rallepalaveev/A2Pico2Lite/TH/A2PicoLite-bare.png

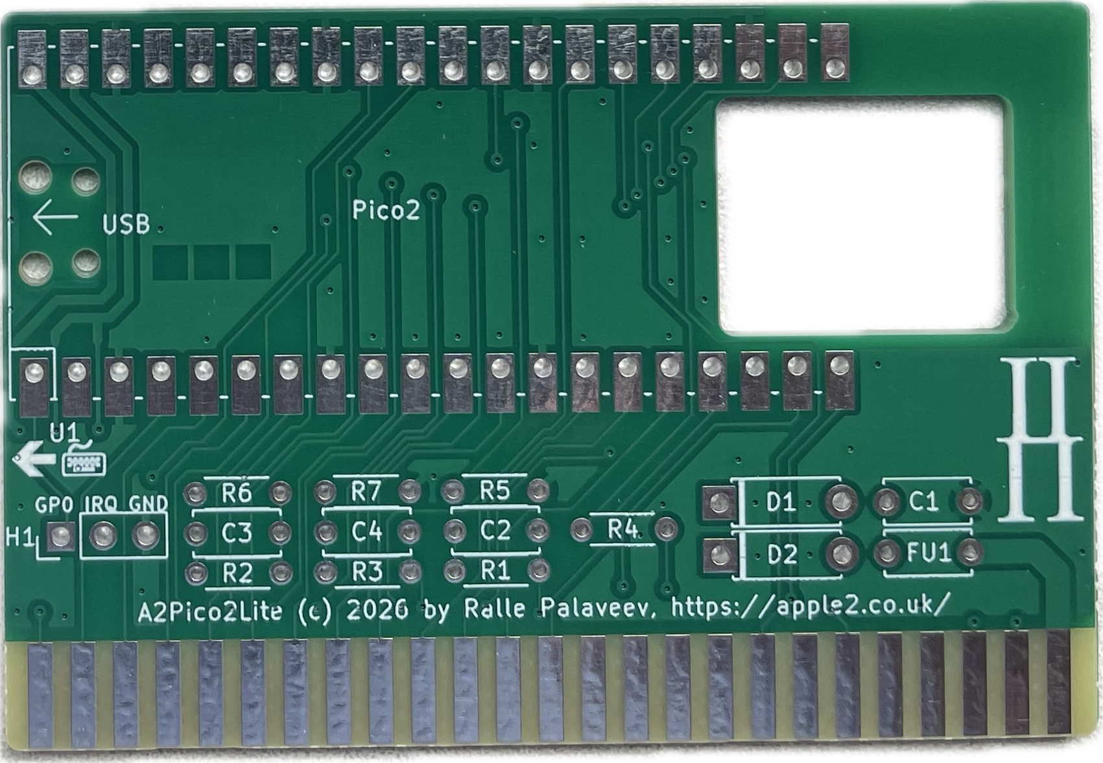
TH/A2PicoLite-bare.png
