rallepalaveev/A2Pico2Lite/TH/A2Pico2Lite.jpg

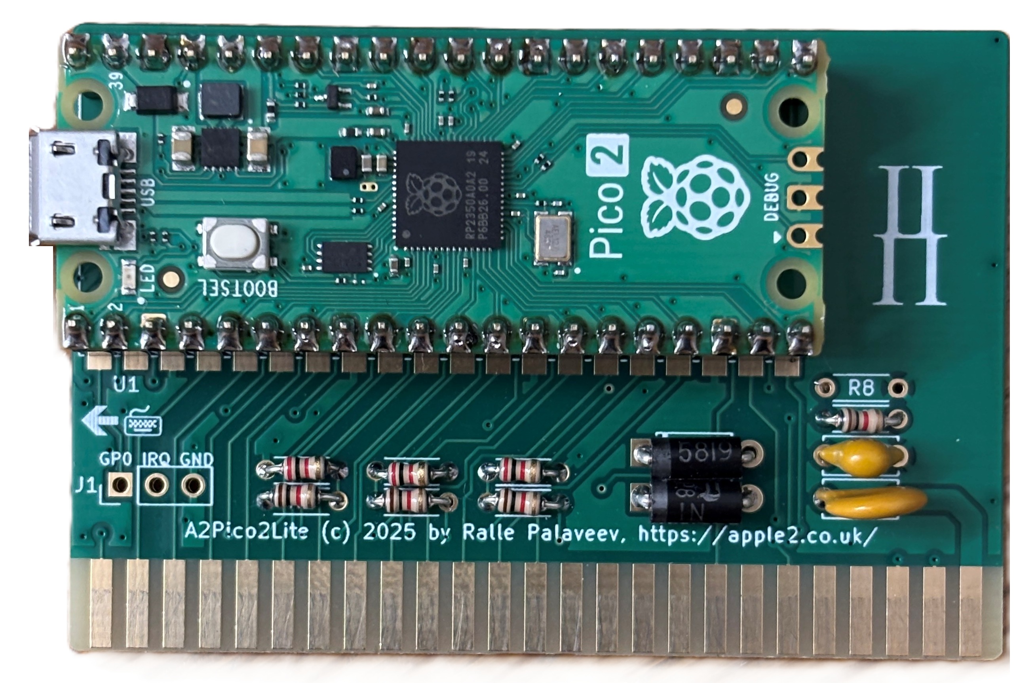
TH/A2Pico2Lite.jpg
