rallepalaveev/A2Pico2Lite/SMT/A2Pico2LiteSMD.jpg

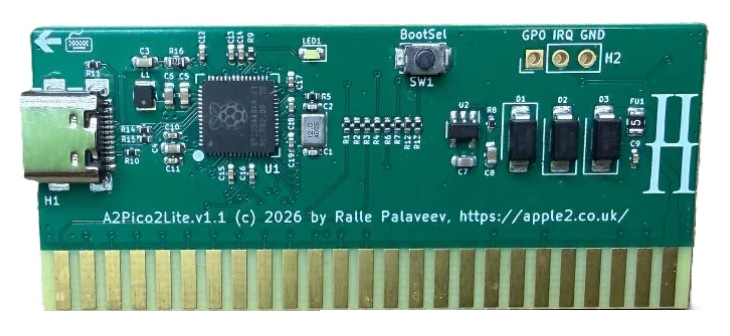
SMT/A2Pico2LiteSMD.jpg
