rallepalaveev/A2Pico2Lite/TH/A2Pico2Lite.png

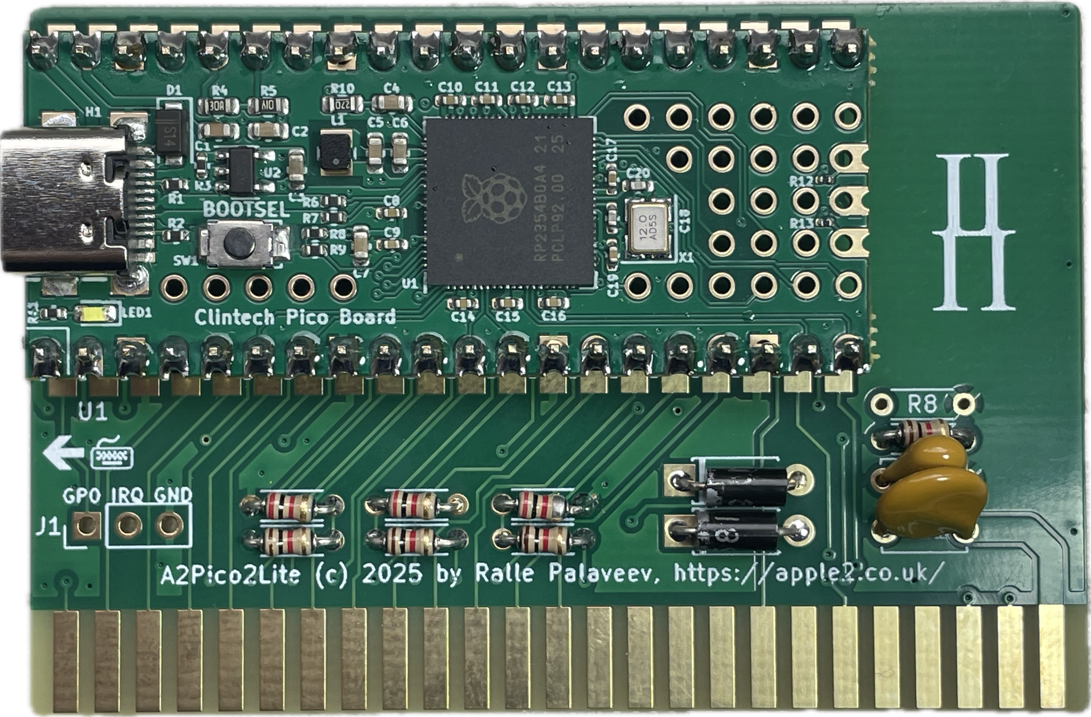
TH/A2Pico2Lite.png
