rallepalaveev/A2Pico2Lite/TH/A2Pico2Lite_render.jpg

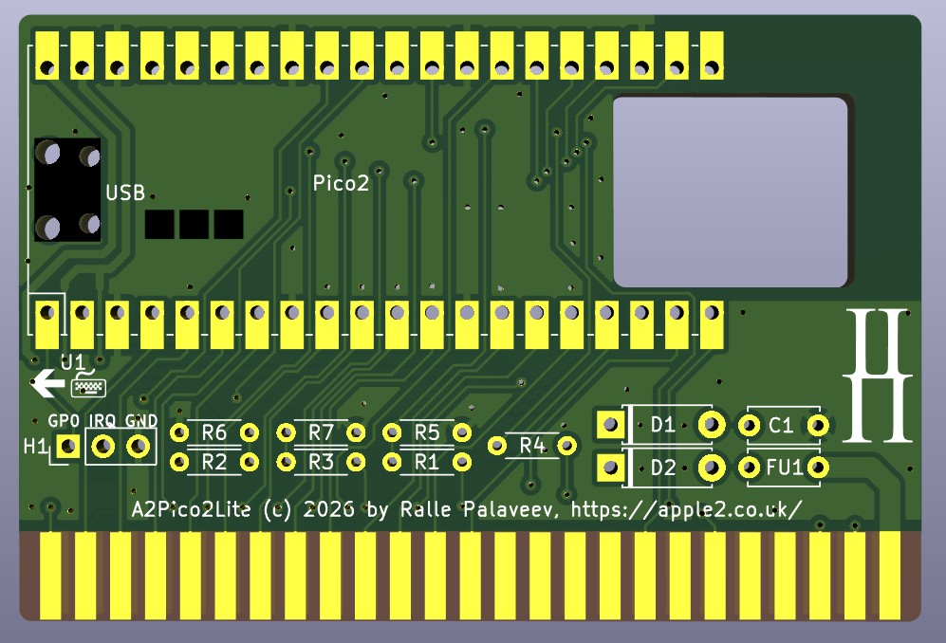
TH/A2Pico2Lite_render.jpg
