rallepalaveev/A2Pico2Lite/W/A2Pico2LiteW.png

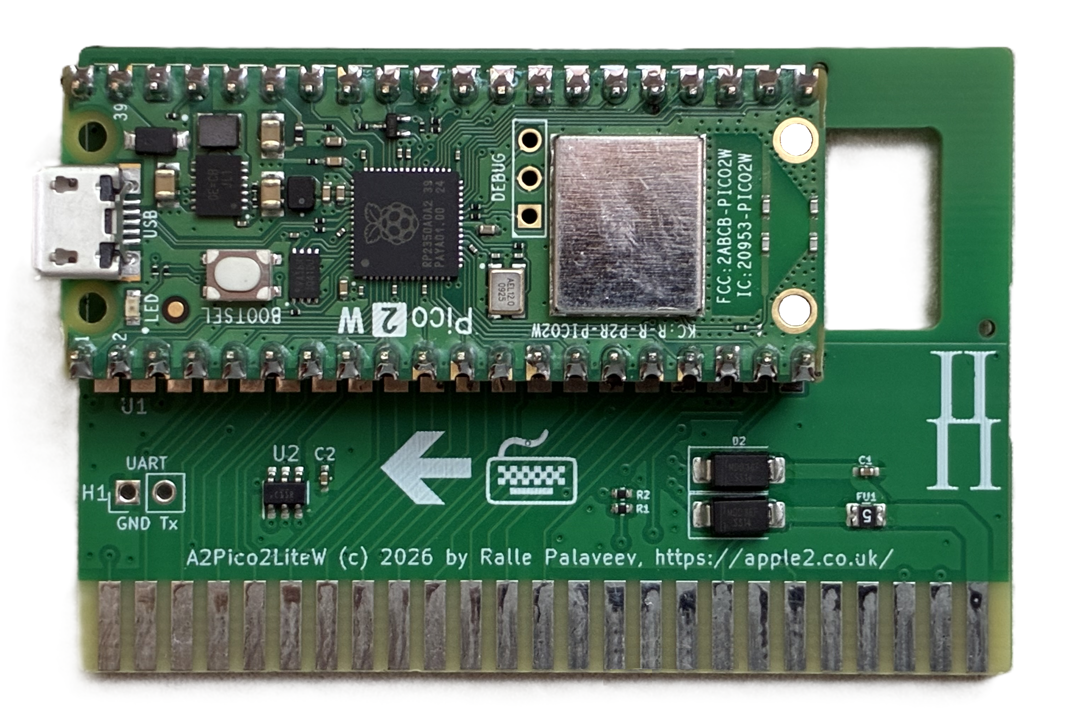
W/A2Pico2LiteW.png
