rallepalaveev/A2Pico2Lite/W/A2Pico2LiteW_BOM.xlsx

Comment | Designator | Footprint | JLCPCB Part #（optional）
16V 100nF X7R ±10% 0402 Multilayer Ceramic Capacitors MLCC | C1,C2 | 0402 | C1525
SS14 | D1,D2 | SMA(DO-214AC) | C2480
6V 500mA Resettable Fuse | FU1 | 0805-50 | C269104
20-pin female header 5mm PN1X20-B CVILUX CB34202V100 | H2,H3 |  | C6763749
1k | R1,R2 | 0402 | C11702
SN74LVC1G11DBVR | U2 | SOT-23-6 | C22046
