rallepalaveev/A2Pico2Lite/SMT/A2Pico2Lite-SMD.v1.0_BOM.xlsx

Comment | Designator | Footprint | JLCPCB Part #（optional）
18pF | C1,C2 | 0402 | C1549
6.3V 4.7uF | C3,C4,C5 | 0603 | C8032
6.3V 10uF 0603 | C6,C7,C8 | 0603 | C19702
16V 100nF 0402 | C9,C10,C11,C12,C13,C14,C15,C16,C17,C18,C19 | 0402 | C1525
SS14 | D1,D2,D3 | SMA(DO-214AC) | C2480
6V 500mA Resettable Fuse | FU1 | 0805-50 | C269104
USB-C-16P-F | H1 | USB-c | C2765186
3.3uH | L1 |  | C48783272
White LED | LED1 | SMD,1.6x0.8mm | C397049
1k | R1,R3,R5,R6,R8,R9,R13 | 0402 | C11702
2k | R2,R4,R7 | 0402 | C4109
5k1 | R10,R11 | 0402 | C25905
27 | R14,R15 | 0402 | C25100
100k | R12 | 0402 | C25741
27 | R16 | 0603 | C25190
TS-3025-A-A-B | SW1 |  | C720477
RP2354A | U1 | QFN-60_EP | C41378174
ME6211 | U2 |  | C82942
12MHz | Y1 | SMD3225-4P | C403945
