rallepalaveev/A2Pico2Lite/W/A2Pico2LiteW.pdf

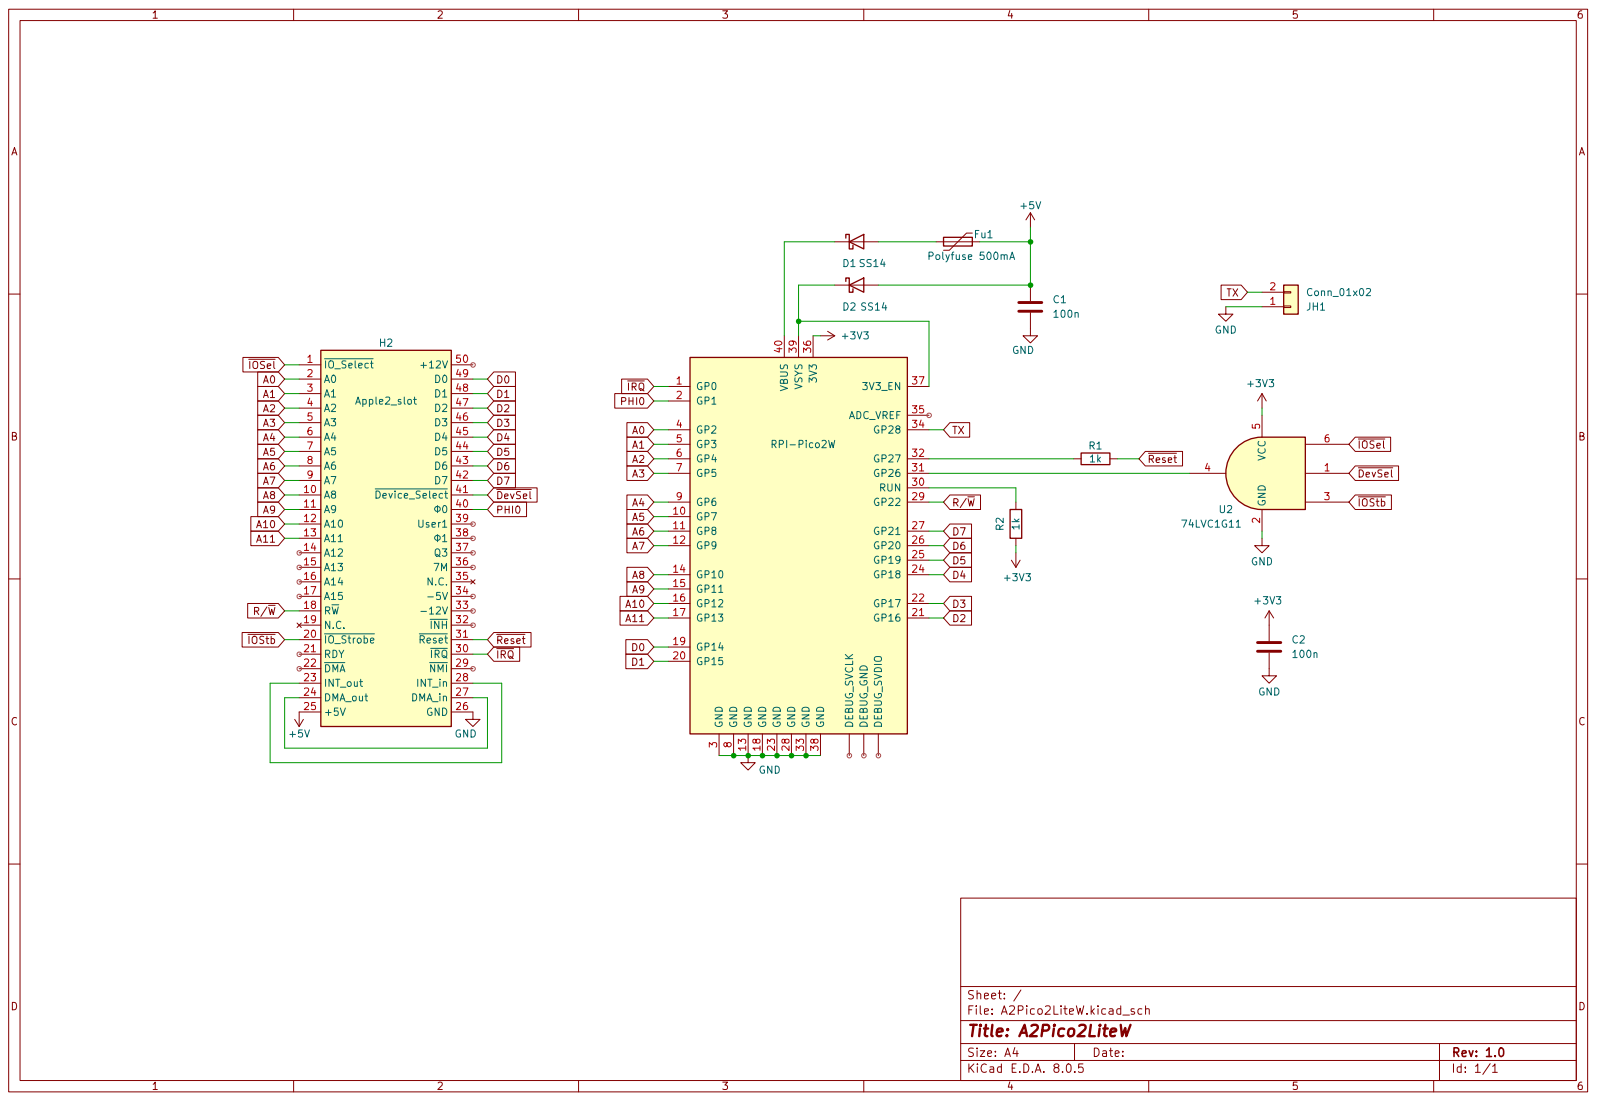
[picture p7: page 1]
