rallepalaveev/A2Pico2Lite/SMT/A2Pico2Lite-SMD.pdf

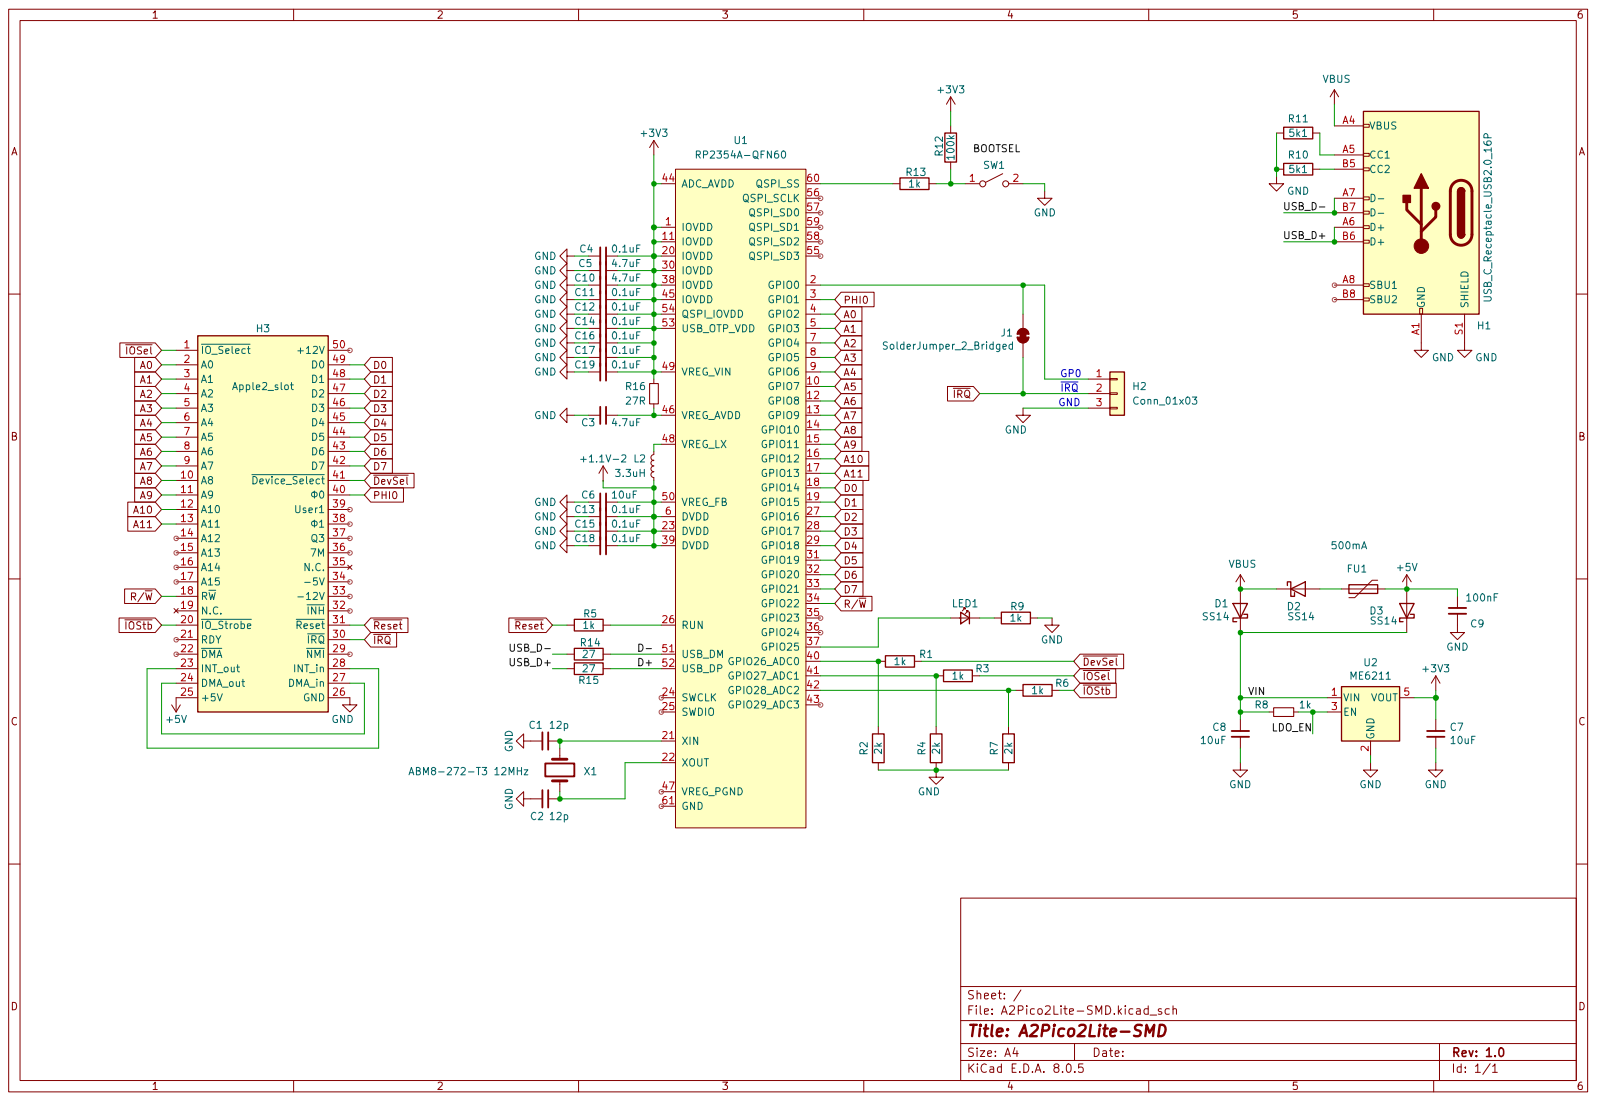
[picture p8: page 1]
