rallepalaveev/A2Pico2Lite/W/A2Pico2LiteW.kicad_pcb

## KiCad design W/A2Pico2LiteW.kicad_pcb (2026-10-16)

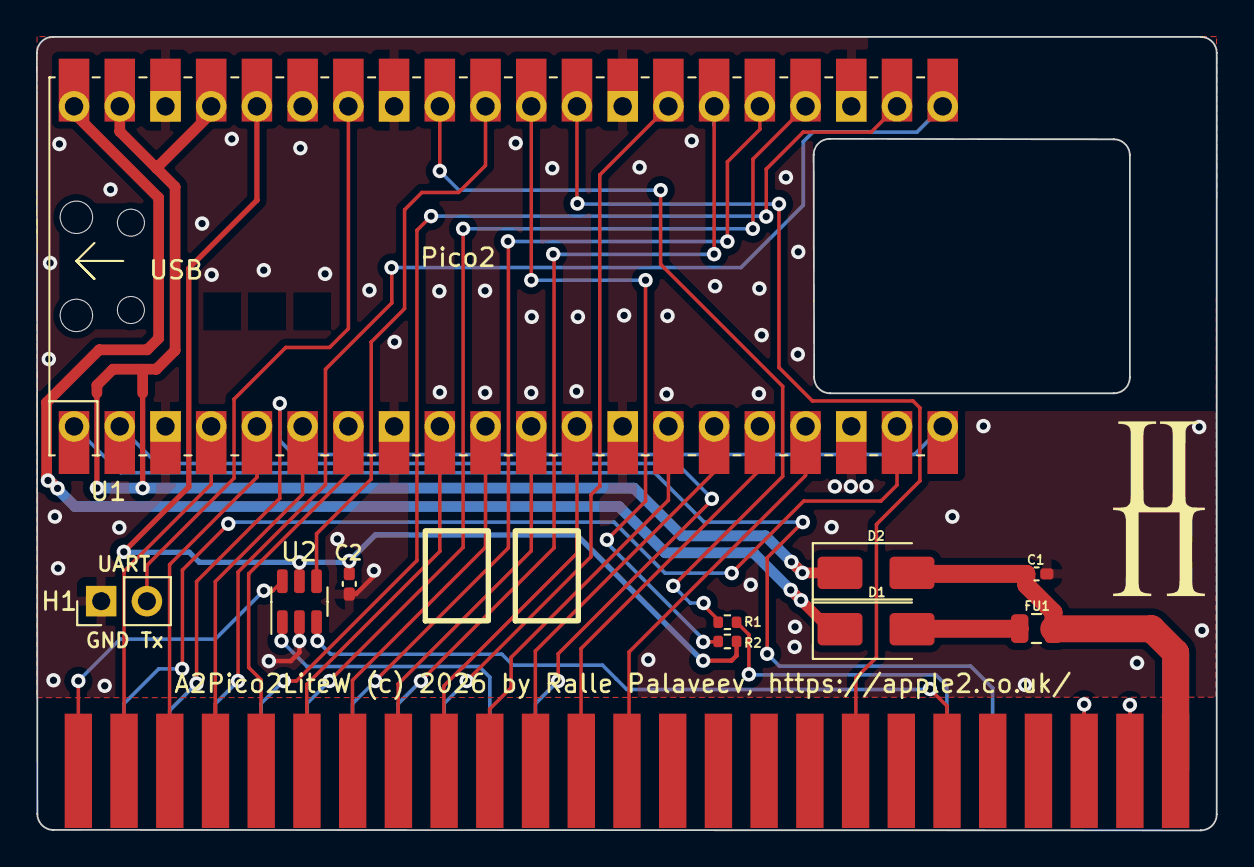
[picture p9: board A2Pico2LiteW.kicad_pcb from above]

Board: 2 copper layers, 65.5 x 44.1 mm, 10 parts (0 on the bottom side), 10 nets.

Parts:
C1, C2: 100n; C_0402_1005Metric_Pad0.74x0.62mm_HandSolder
D1, D2: SS14; D_SMA
FU1: 500mA; Fuse_0805_2012Metric
H1: PinHeader_1x02_P2.54mm_Vertical
R1, R2: 1k; R_0402_1005Metric
U1: Pico; RPi_PicoW_SMD_TH
U2: SN74LVC1G11DBVR; SOT-23-6

Connections:
3.3V: C2.1, R2.1, U1.36 (3V3), U2.5
5V: C1.1, D2.2, FU1.1
5V-1: D1.2, FU1.2
GND: C1.2, C2.2, H1.1, U1.3 (GND), U1.8 (GND), U1.13 (GND), U1.18 (GND), U1.23 (GND), U1.28 (GND), U1.33 (AGND), U1.38 (GND), U2.2
RUN: R2.2, U1.30 (RUN)
Tx: H1.2, U1.34 (GPIO28_ADC2)
VBUS: D1.1, U1.40 (VBUS)
VSYS: D2.1, U1.37 (3V3_EN), U1.39 (VSYS)
~Enable: U1.31 (GPIO26_ADC0), U2.4
~Reset_: R1.2, U1.32 (GPIO27_ADC1)
