rallepalaveev/A2Pico2Lite/SMT/A2Pico2Lite-SMD.kicad_pcb

## KiCad design SMT/A2Pico2Lite-SMD.kicad_pcb (2026-09-07)

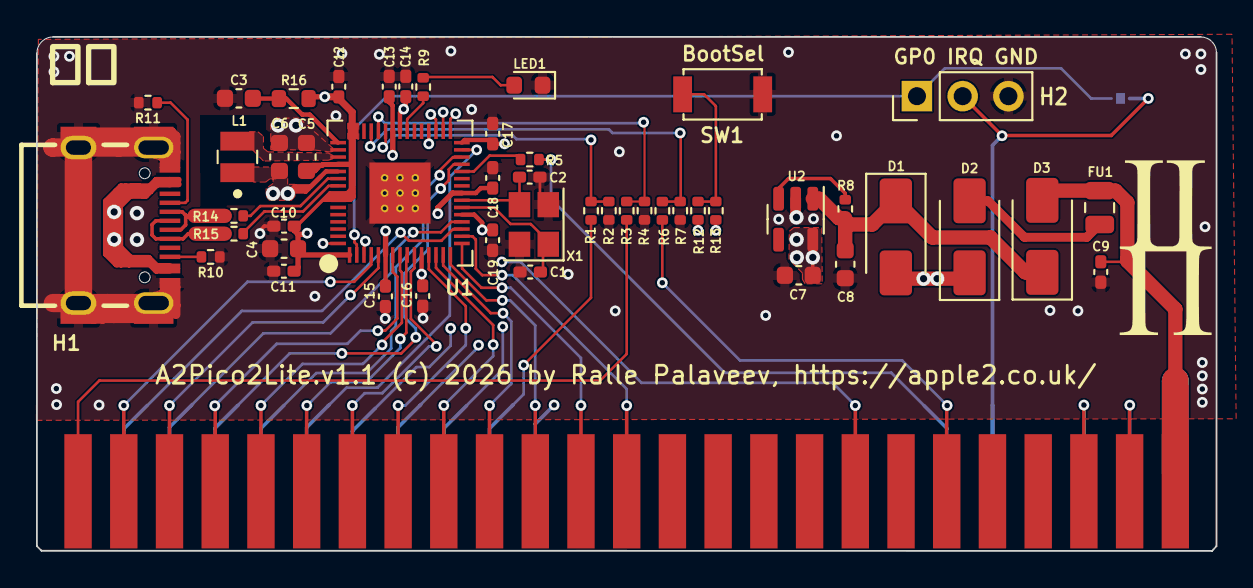
[picture p10: board A2Pico2Lite-SMD.kicad_pcb from above]

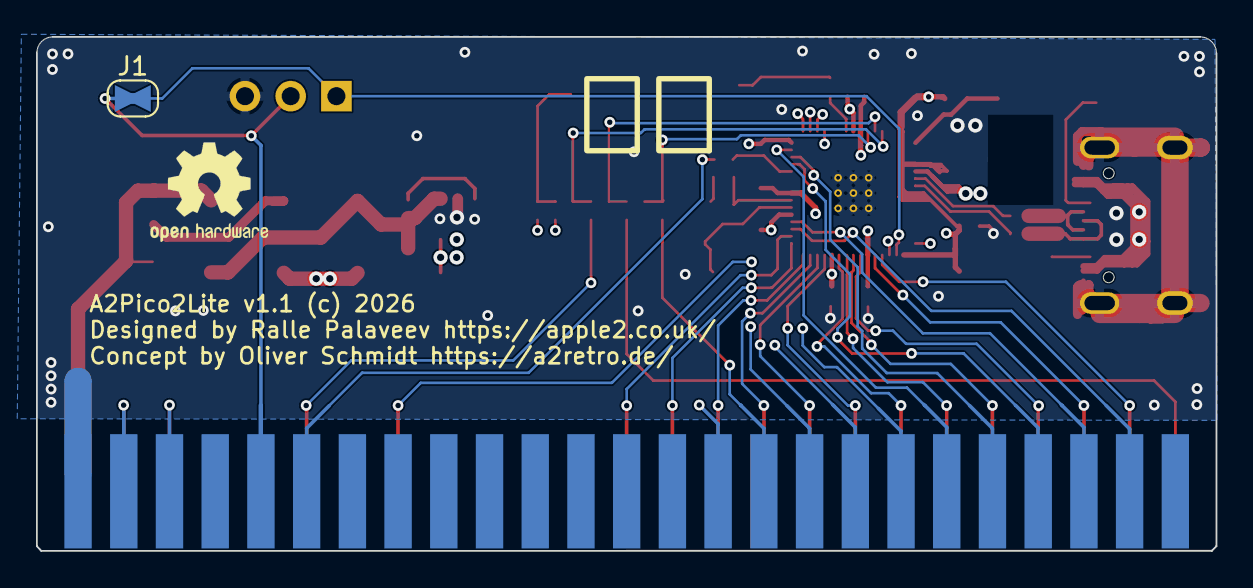
[picture p11: board A2Pico2Lite-SMD.kicad_pcb from below]

Board: 4 copper layers, 65.5 x 28.6 mm, 50 parts (2 on the bottom side), 28 nets.

Parts:
C1, C2: 12pF; C_0402_1005Metric_Pad0.74x0.62mm_HandSolder
C3, C4, C5: 4.7uF; C_0603_1608Metric
C6, C7, C8: 10uF; C_0603_1608Metric
C9, C10, C11, C12, C13, C14, C15, C16, C17, C18, C19: 100n; C_0402_1005Metric_Pad0.74x0.62mm_HandSolder
D1, D2, D3: SS14; D_SMA
FU1: 500mA; Fuse_0805_2012Metric
G1: LOGO
G2: OSHW-Logo2_7.3x6mm_SilkScreen
H1: USB-C-16P-F(A40-00119-A52-12); USB2.0_TYPE-C(A40-00119-A52-12)
H2: PinHeader_1x03_P2.54mm_Vertical
J1: SolderJumper-2_P1.3mm_Bridged_RoundedPad1.0x1.5mm
L1: 3.3uH; L_Wuerth_MAPI-2512
LED1: LED_CHR; LED_0603_1608Metric
R1, R3, R6, R8, R9, R13: 1k; R_0402_1005Metric
R2, R4, R5, R7: 2k; R_0402_1005Metric
R10, R11: 5k1; R_0402_1005Metric
R12: 100k; R_0402_1005Metric
R14, R15: 27; R_0402_1005Metric
R16: 27; R_0603_1608Metric
SW1: SW_BOOTSEL; SW_SPST_B3U-1000P
U1: RP2354A_QFN-60_EP_7.75x7.75_Pitch0.4mm; RP2350A_QFN-60_EP_7.75x7.75_Pitch0.4mm
U2: ME6211; SOT-23-5
X1: Crystal_SMD_Abracon_ABM8AIG-4Pin_3.2x2.5mm

Connections:
+1.1V: C6.1, C13.1, C15.1, C18.1, L1.1, U1.6, U1.23, U1.39, U1.50
+1.1V_reg: L1.2, U1.48
+3V3: C4.1, C5.1, C7.2, C10.1, C11.1, C12.1, C14.1, C16.1, C17.1, C19.1, R12.1, R16.2, U1.1, U1.11, U1.20, U1.30, U1.38, U1.44, U1.45, U1.49, U1.53, U1.54, U2.5 (VOUT)
+5V: C9.1, D3.2, FU1.1
+5V-1: D2.2, FU1.2
/D+: R15.2, U1.52
/D-: R14.2, U1.51
/LDO_EN: R8.1, U2.3 (EN)
/USB_D+: H1.A6, H1.B6, R15.1
/USB_D-: H1.A7, H1.B7, R14.1
/VIN: C8.1, D1.1, D3.1, R8.2, U2.1 (VIN)
BootSel: R12.2, R13.2, SW1.1 (A)
GND: C1.2, C2.2, C3.1, C4.2, C5.2, C6.2, C7.1, C8.2, C9.2, C10.2, C11.2, C12.2, C13.2, C14.2, C15.2, C16.2, C17.2, C18.2, C19.2, H1.0, H1.A1, H1.A12, H1.B1, H1.B12, H2.3, LED1.1 (K), R2.2, R4.2, R7.2, R10.2, R11.1, SW1.2 (B), U1.47, U1.61, U2.2 (GND), X1.2, X1.4
GPIO0: H2.1, J1.2, U1.2
GPIO25: R9.2, U1.37
LED: LED1.2 (A), R9.1
QSPI_SS: R13.1, U1.60
REG_AVDD: C3.2, R16.1, U1.46
RUN: R5.1, U1.26
USB-A5: H1.A5, R11.2
USB-B5: H1.B5, R10.1
VBUS: D1.2, D2.1, H1.A4, H1.A9, H1.B4, H1.B9
XIN: C1.1, U1.21, X1.1
XOUT: C2.1, U1.22, X1.3
~DevSel_: R1.1, R2.1, U1.40
~IOSel_: R3.1, R4.1, U1.41
~IOStr_: R6.1, R7.1, U1.42
~IRQ: H2.2, J1.1
