rallepalaveev/A2Pico2Lite/TH/A2Pico2Lite.kicad_pcb

## KiCad design TH/A2Pico2Lite.kicad_pcb (2026-08-24)

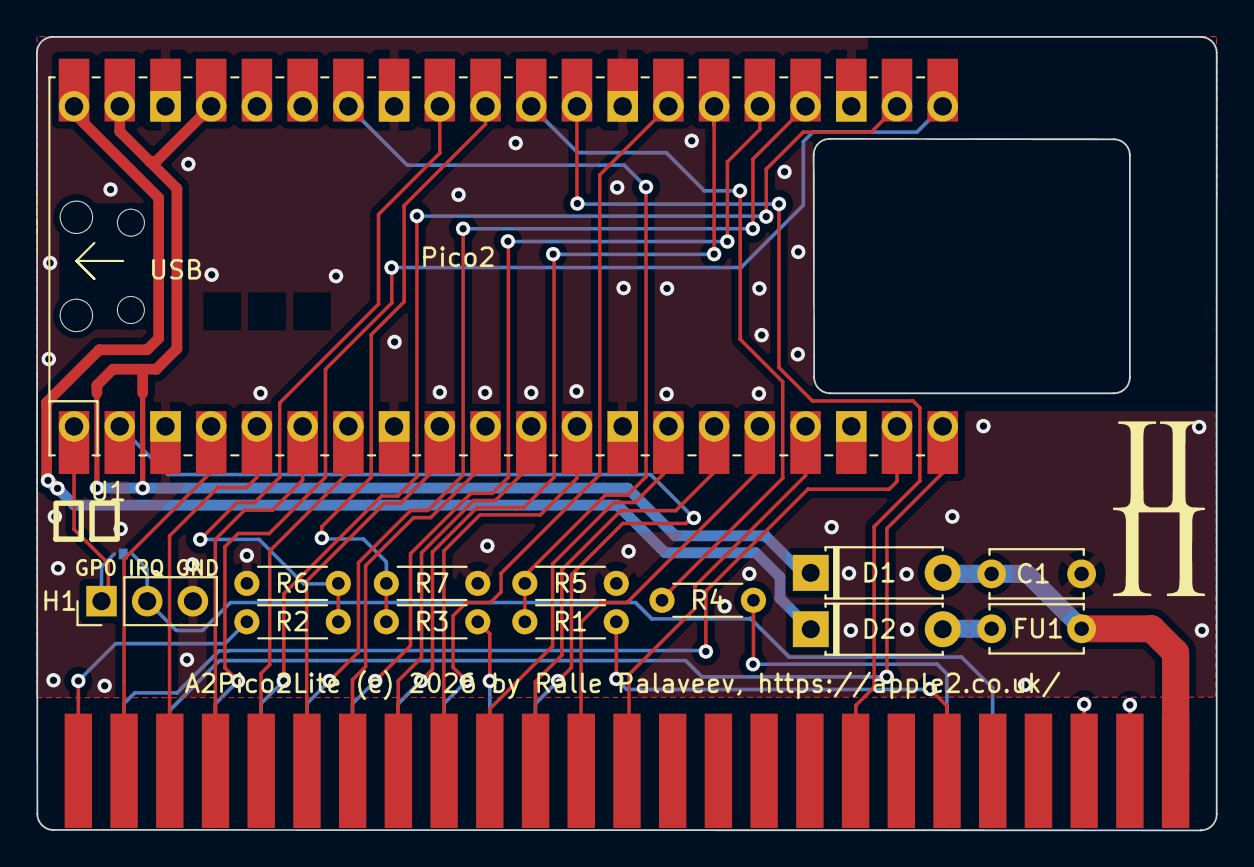
[picture p12: board TH/A2Pico2Lite.kicad_pcb from above]

Board: 2 copper layers, 65.5 x 44.1 mm, 14 parts (1 on the bottom side), 11 nets.

Parts:
C1: 100n; C_Disc_D5.0mm_W2.5mm_P5.00mm
D1, D2: D_T-1_P5.08mm_Horizontal
FU1: 500mA; C_Disc_D5.0mm_W2.5mm_P5.00mm
H1: PinHeader_1x03_P2.54mm_Vertical
J2: SolderJumper-2_P1.3mm_Bridged_RoundedPad1.0x1.5mm
R1, R2, R3: 1k; R_Axial_DIN0204_L3.6mm_D1.6mm_P5.08mm_Horizontal
R4, R5, R6, R7: 2k; R_Axial_DIN0204_L3.6mm_D1.6mm_P5.08mm_Horizontal
U1: Pico; RPi_PicoW_SMD_TH

Connections:
5V: C1.1, D1.2, FU1.1
5V-1: D2.2, FU1.2
GND: C1.2, H1.3, R5.1, R6.2, R7.1, U1.3 (GND), U1.8 (GND), U1.13 (GND), U1.18 (GND), U1.23 (GND), U1.28 (GND), U1.33 (AGND), U1.38 (GND)
GPIO0: H1.1, J2.2, U1.1 (GPIO0)
RUN: R4.2, U1.30 (RUN)
VBUS: D2.1, U1.40 (VBUS)
VSYS: D1.1, U1.37 (3V3_EN), U1.39 (VSYS)
~DevSel_: R3.2, R7.2, U1.31 (GPIO26_ADC0)
~IOSel_: R2.1, R6.1, U1.32 (GPIO27_ADC1)
~IOStb_: R1.2, R5.2, U1.34 (GPIO28_ADC2)
~IRQ: H1.2, J2.1
