rallepalaveev/A2Pico2Lite/(commit log)

2025-12-06 Update and rename A2Pico2Lite.kicad_pcb to TH/A2Pico2Lite.kicad_pcb
    [A2Pico2Lite.kicad_pcb]
2025-12-06 Update and rename A2Pico2Lite.kicad_sch to TH/A2Pico2Lite.kicad_sch
    [A2Pico2Lite.kicad_sch]
