rallepalaveev/A2Pico2Lite/(notices)

Notices in the files:
A2Pico2Lite.kicad_pcb:
A2Pico2Lite (c) 2025
A2Pico2Lite (c) 2025 by Ralle Palaveev, https://apple2.co.uk
TH/A2Pico2Lite.kicad_pcb:
A2Pico2Lite (c) 2026
A2Pico2Lite (c) 2026 by Ralle Palaveev, https://apple2.co.uk
SMT/A2Pico2Lite-SMD.kicad_pcb:
A2Pico2Lite v1.1 (c) 2026
A2Pico2Lite.v1.1 (c) 2026 by Ralle Palaveev, https://apple2.co.uk
W/A2Pico2LiteW.kicad_pcb:
A2Pico2LiteW (c) 2026
A2Pico2LiteW (c) 2026 by Ralle Palaveev, https://apple2.co.uk
